Purdue-AM/CPT_printer/Plasma Printer Photos/20190710_125836.jpg

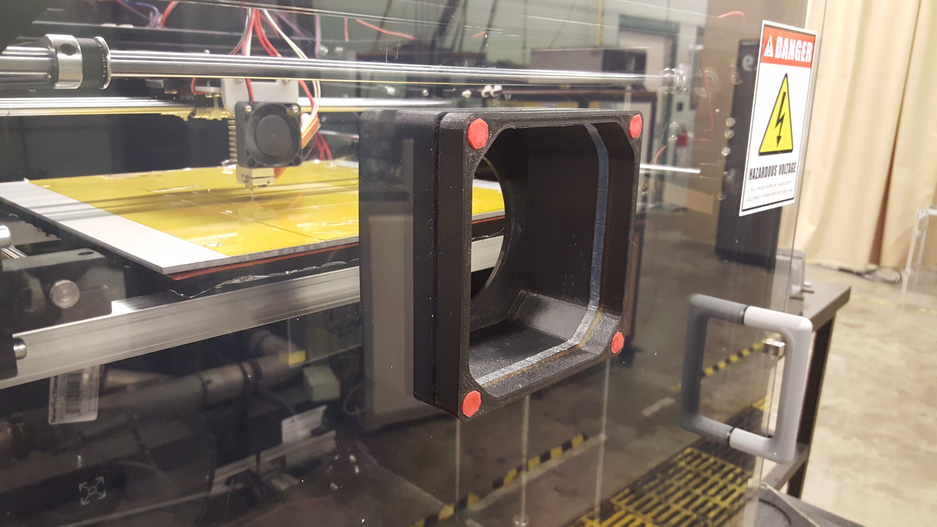
Plasma Printer Photos/20190710_125836.jpg
