Purdue-AM/CPT_printer/Plasma Printer Photos/20190710_130702.jpg

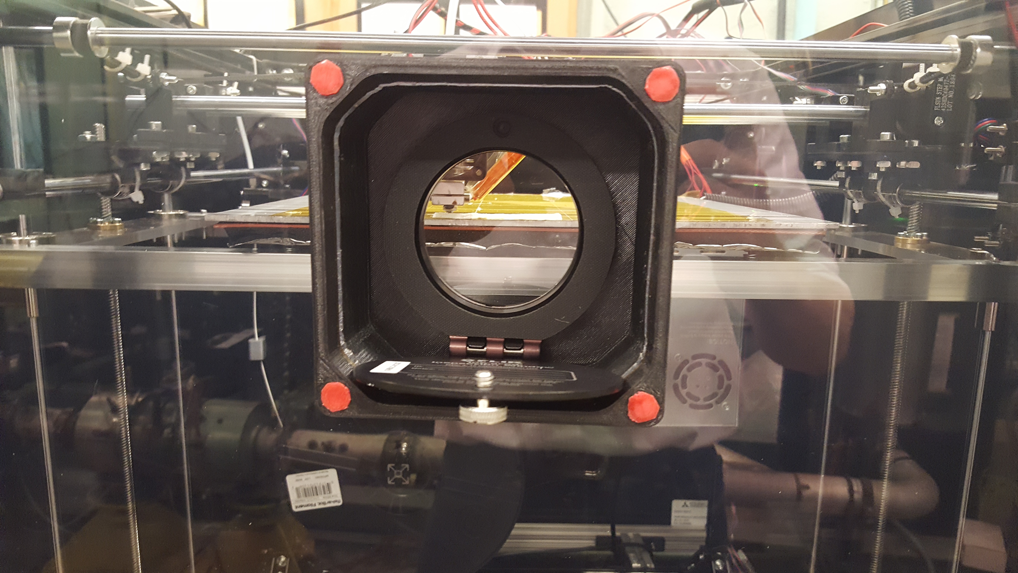
Plasma Printer Photos/20190710_130702.jpg
