Purdue-AM/CPT_printer/README.md

# CPT_printer
Mechanical, electrical, and code files for the Corona/Cold Plasma Treatment Printer in the Rhoads Research Group at Purdue University.
