Purdue-AM/CPT_printer/Plasma Printer Hardware/Ozone Sensor Mount/ozone_mount.SLDASM

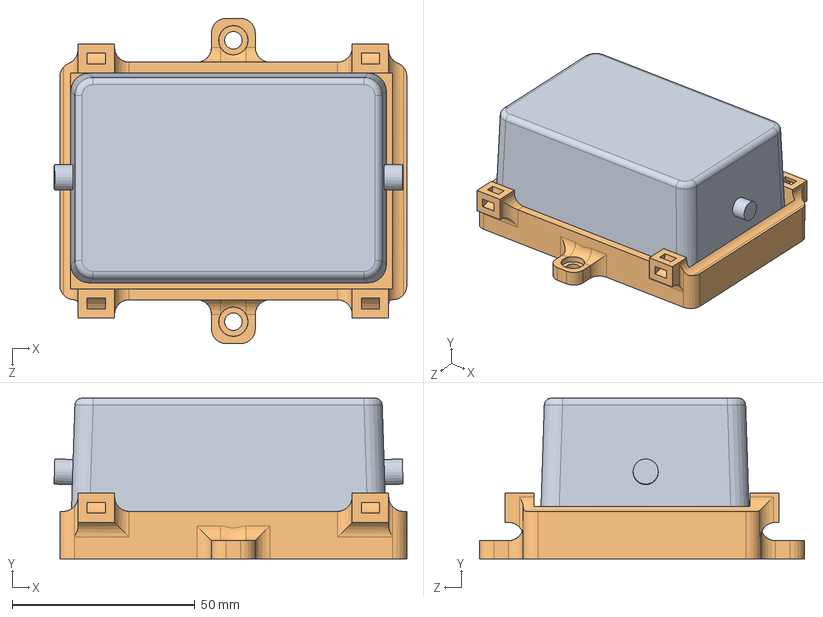
[picture p3: CAD file, 2019-09-11]
Plasma Printer Hardware/Ozone Sensor Mount/ozone_mount.SLDASM
96.6 x 44.0 x 89.0 mm
ozone sensor
mount_bottom
