Purdue-AM/CPT_printer/Plasma Printer Hardware/Print Head Assembly/STLs/plasma_frame_test.STL

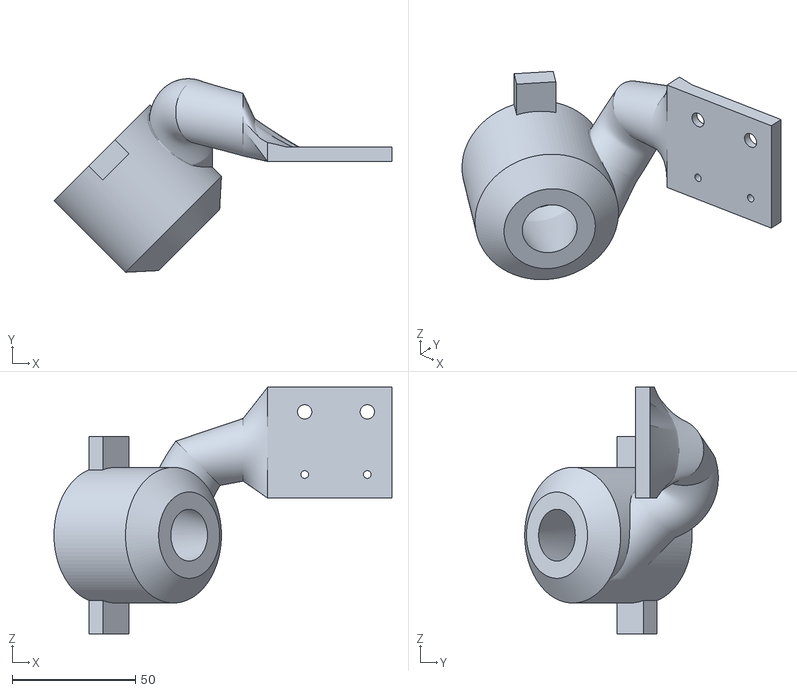
[picture p4: CAD file, 2019-09-11]
Plasma Printer Hardware/Print Head Assembly/STLs/plasma_frame_test.STL
137.0 x 78.5 x 100.0
