Purdue-AM/CPT_printer/Plasma Printer Hardware/Print Head Assembly/plasma_front_cone.SLDPRT

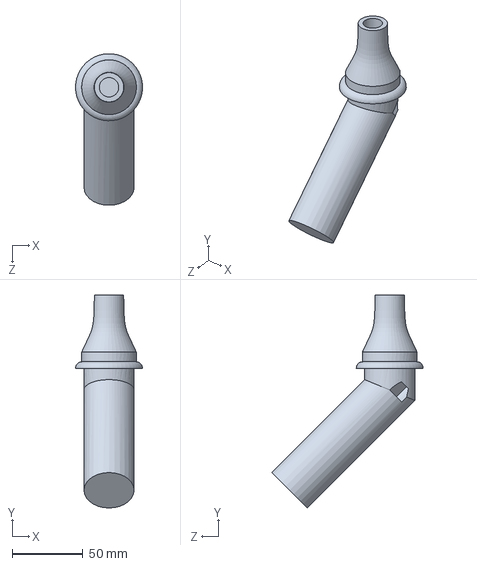
[picture p5: CAD file, 2019-09-11]
Plasma Printer Hardware/Print Head Assembly/plasma_front_cone.SLDPRT
47.3 x 150.2 x 106.8 mm
