Purdue-AM/CPT_printer/Plasma Printer Hardware/IR Window Sub-Assembly/Window Assembly.SLDASM

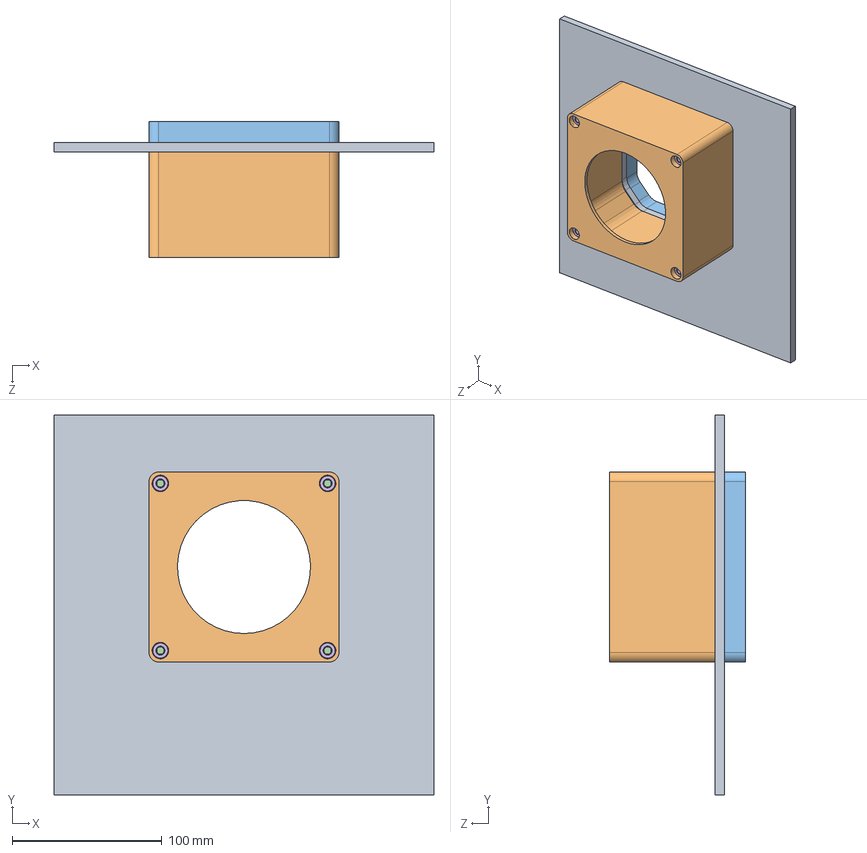
[picture p6: CAD file, 2019-09-11]
Plasma Printer Hardware/IR Window Sub-Assembly/Window Assembly.SLDASM
254.0 x 254.0 x 91.1 mm
Door
conductive bushing
conductive bushing outside
socket head cap screw_am x 4
bolt cover x 4
hex nut style 1_am x 4
