Purdue-AM/CPT_printer/Plasma Printer Hardware/Print Head Assembly/print head assembly.SLDASM

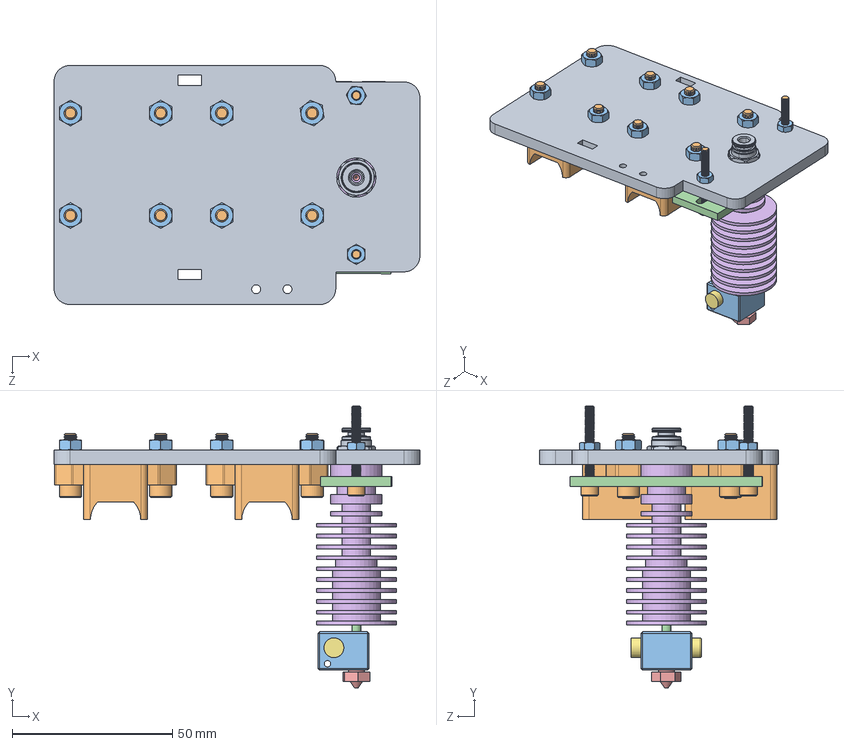
[picture p7: CAD file, 2019-09-11]
Plasma Printer Hardware/Print Head Assembly/print head assembly.SLDASM
114.4 x 88.0 x 74.7 mm
mounting plate
bearing housing x 4
E3D Heat Block
E3D Heatbreak
E3D Nozzle
E3D Heatsink
cartridge heater
thermistor
PB156_1_8
socket head cap screw_am x 10
hex nut style 1_am x 10
hotend bracket
