Purdue-AM/CPT_printer/Plasma Printer Hardware/Enclosure Parts/back_door_hinge.SLDASM

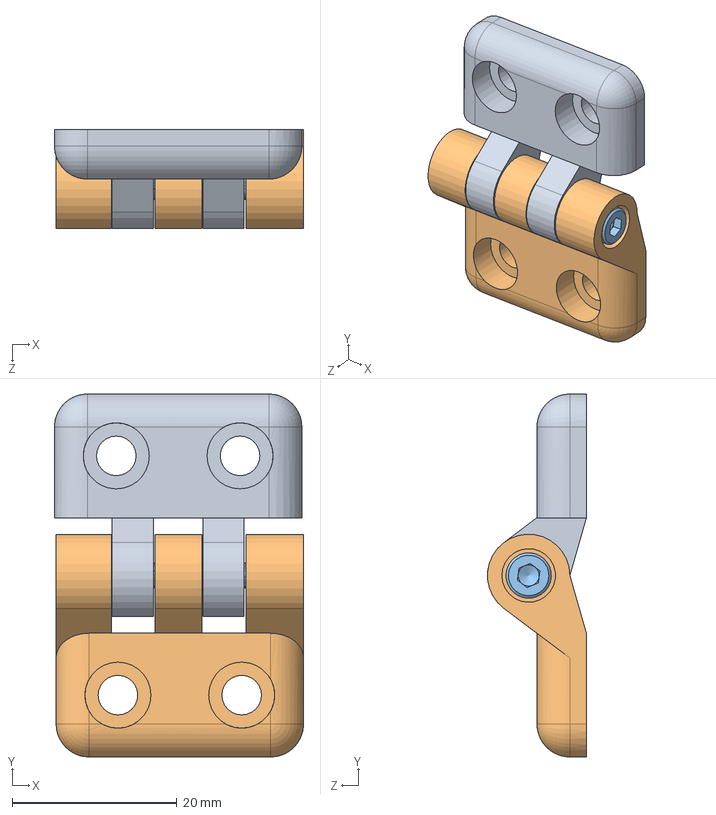
[picture p8: CAD file, 2019-09-11]
Plasma Printer Hardware/Enclosure Parts/back_door_hinge.SLDASM
30.2 x 44.0 x 12.0 mm
hinge_arm
hinge_backdoor_base
socket head cap screw_am
