Purdue-AM/CPT_printer/Plasma Printer Hardware/Print Head Assembly/Hot End Assembly/E3D.SLDASM

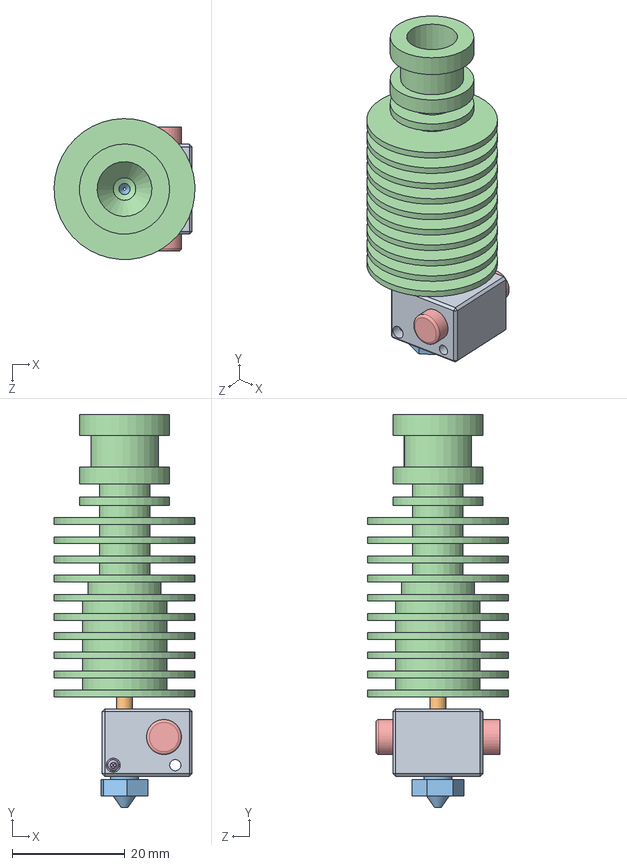
[picture p9: CAD file, 2019-09-11]
Plasma Printer Hardware/Print Head Assembly/Hot End Assembly/E3D.SLDASM
25.0 x 69.7 x 25.0 mm
E3D Heat Block
E3D Heatbreak
E3D Nozzle
E3D Heatsink
cartridge heater
thermistor
