Purdue-AM/CPT_printer/Plasma Printer Hardware/Print Head Assembly/plasma_frame.SLDPRT

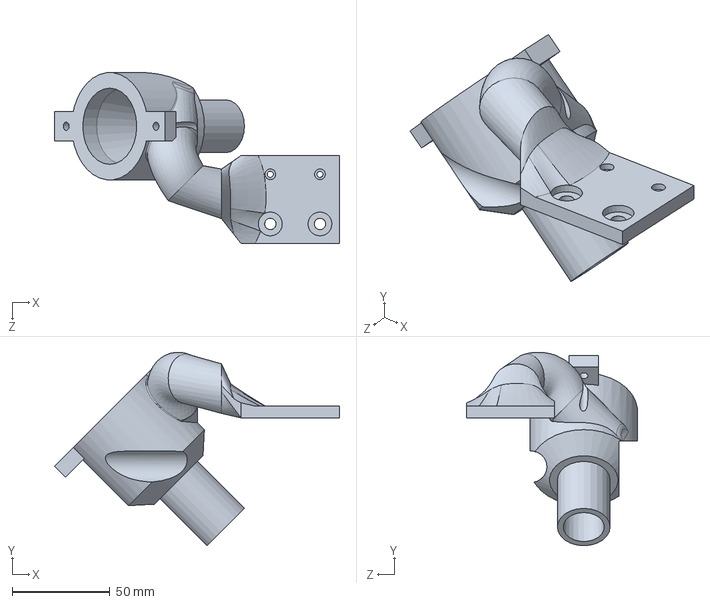
[picture p10: CAD file, 2019-09-11]
Plasma Printer Hardware/Print Head Assembly/plasma_frame.SLDPRT
145.9 x 99.0 x 87.5 mm
