Purdue-AM/CPT_printer/Plasma Printer Hardware/Print Head Assembly/plasma_frame_top.SLDPRT

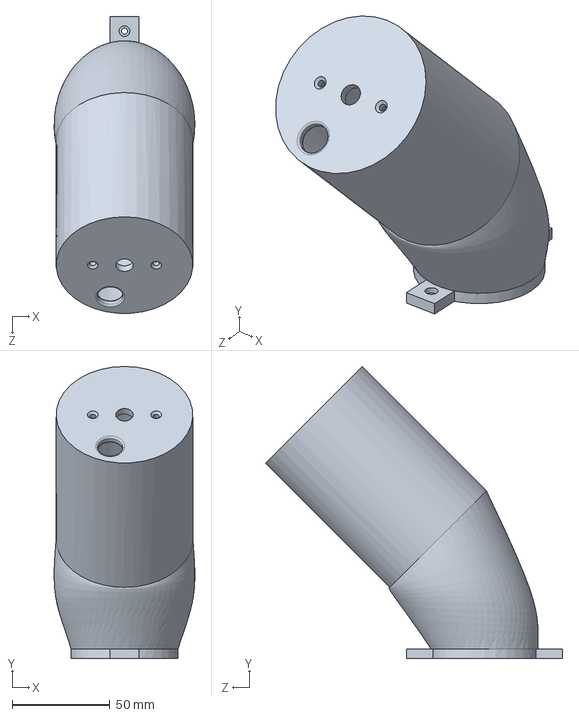
[picture p11: CAD file, 2019-09-11]
Plasma Printer Hardware/Print Head Assembly/plasma_frame_top.SLDPRT
72.0 x 149.6 x 152.1 mm
