Purdue-AM/CPT_printer/Plasma Printer Hardware/Print Head Assembly/new frame assembly.SLDASM

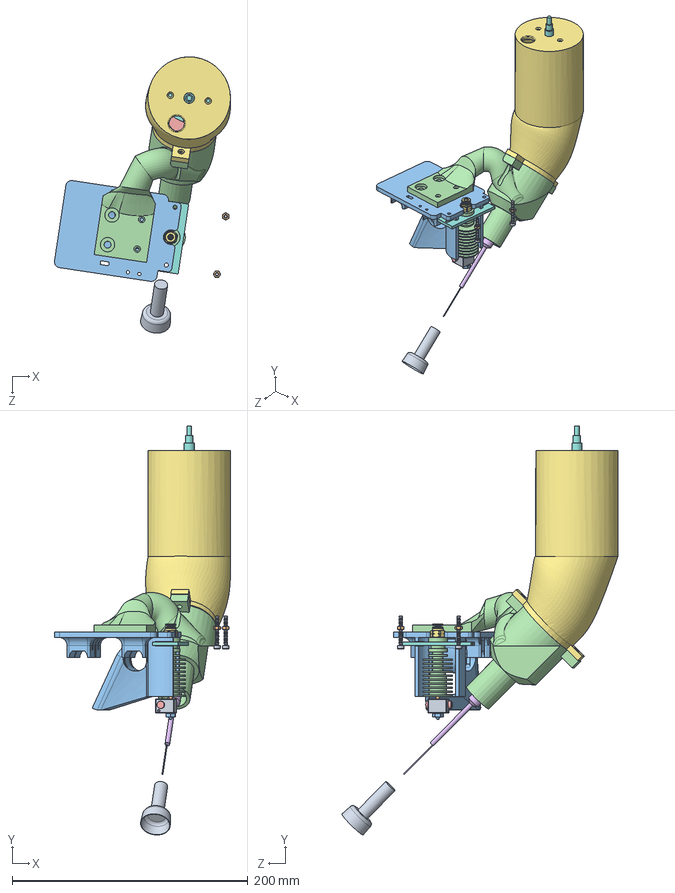
[picture p12: CAD file, 2019-09-11]
Plasma Printer Hardware/Print Head Assembly/new frame assembly.SLDASM
149.5 x 347.2 x 234.5 mm
E3D Heat Block
E3D Heatbreak
E3D Nozzle
E3D Heatsink
cartridge heater
thermistor
PB156_1_8
hotend bracket
socket head cap screw_am x 2
hex nut style 1_am x 2
combined_frame
plasma_frame
plasma_front_cone
needle_tip
plasma_frame_top
spark_gap
cup_tip
