Purdue-AM/CPT_printer/Plasma Printer Hardware/Enclosure Parts/hinge_backdoor_base.SLDPRT

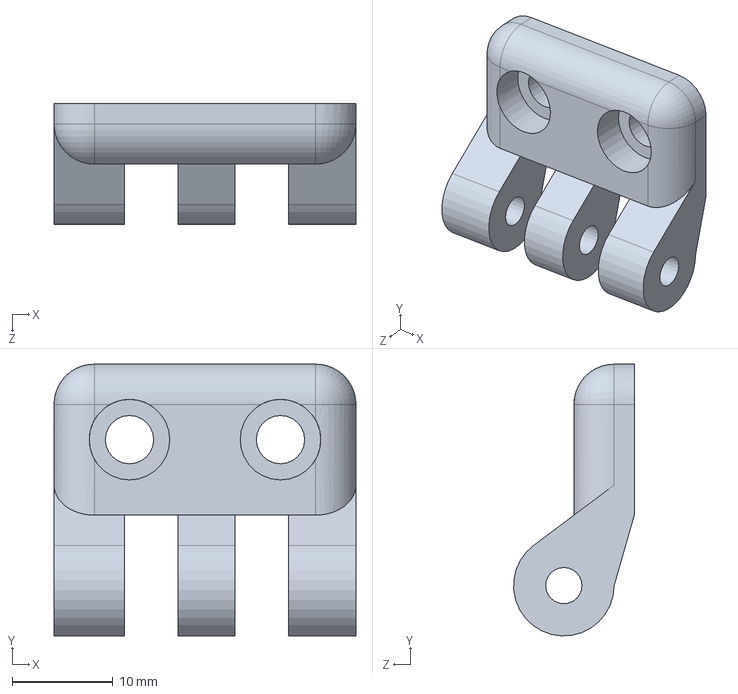
[picture p13: CAD file, 2019-09-11]
Plasma Printer Hardware/Enclosure Parts/hinge_backdoor_base.SLDPRT
30.0 x 27.0 x 12.0 mm
