Purdue-AM/CPT_printer/Plasma Printer Hardware/IR Window Sub-Assembly/conductive bushing outside.SLDPRT

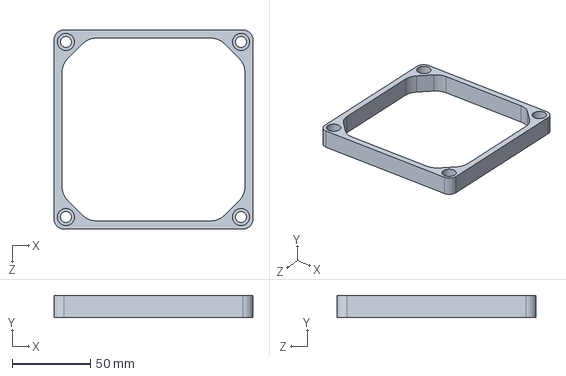
[picture p14: CAD file, 2019-09-11]
Plasma Printer Hardware/IR Window Sub-Assembly/conductive bushing outside.SLDPRT
127.0 x 14.3 x 127.0 mm
