Purdue-AM/CPT_printer/Plasma Printer Hardware/Plasma Generator Parts/cup_tip.SLDPRT

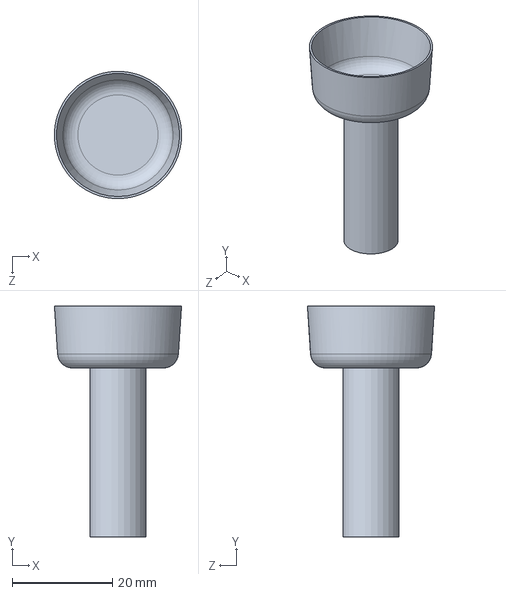
[picture p15: CAD file, 2019-09-11]
Plasma Printer Hardware/Plasma Generator Parts/cup_tip.SLDPRT
25.3 x 46.0 x 25.3 mm
