Purdue-AM/CPT_printer/Plasma Printer Hardware/Print Head Assembly/new_frame.SLDPRT

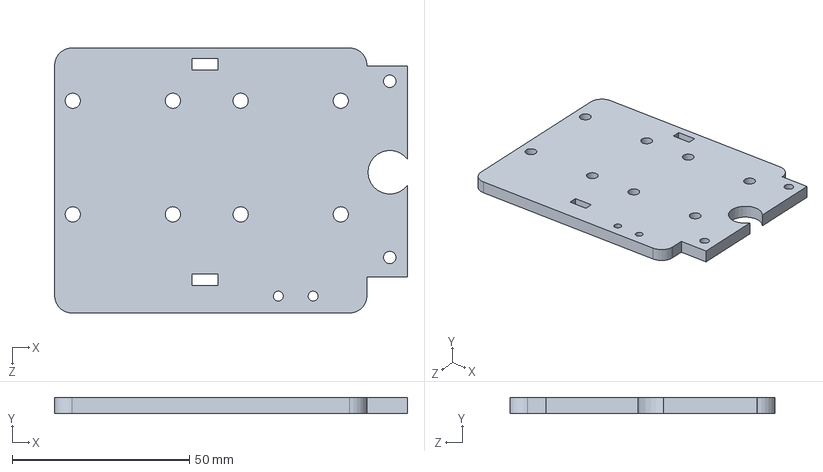
[picture p16: CAD file, 2019-09-11]
Plasma Printer Hardware/Print Head Assembly/new_frame.SLDPRT
99.4 x 4.55 x 74.7 mm
