Purdue-AM/CPT_printer/Plasma Printer Hardware/Enclosure Parts/2020_conn.SLDPRT

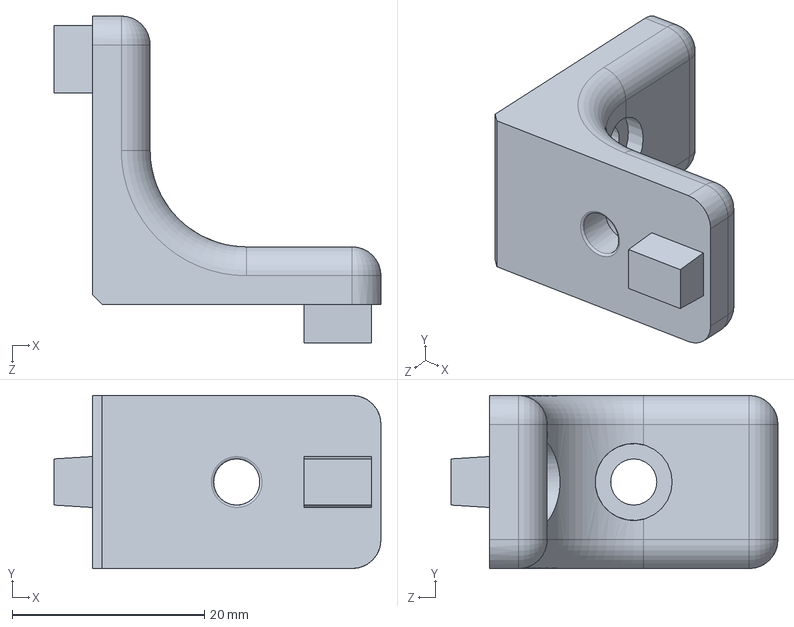
[picture p17: CAD file, 2019-09-11]
Plasma Printer Hardware/Enclosure Parts/2020_conn.SLDPRT
34.0 x 18.0 x 34.0 mm
