Purdue-AM/CPT_printer/Plasma Printer Hardware/IR Window Sub-Assembly/conductive bushing.SLDPRT

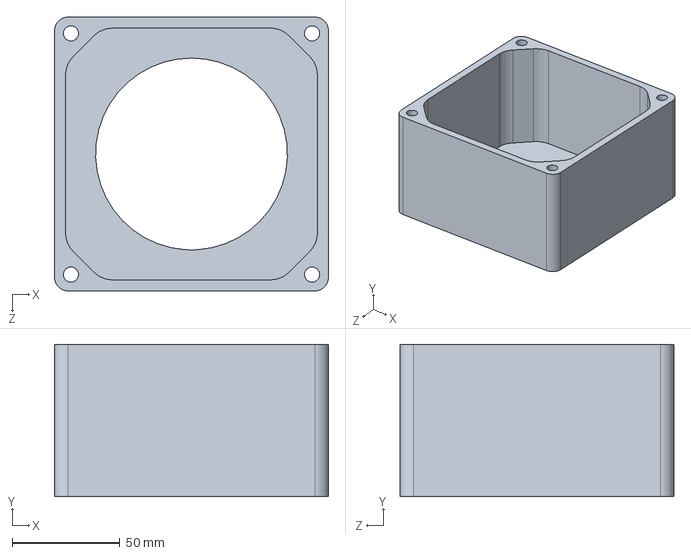
[picture p18: CAD file, 2019-09-11]
Plasma Printer Hardware/IR Window Sub-Assembly/conductive bushing.SLDPRT
127.0 x 70.5 x 127.0 mm
