Purdue-AM/CPT_printer/Plasma Printer Hardware/Ozone Sensor Mount/ozone sensor.SLDPRT

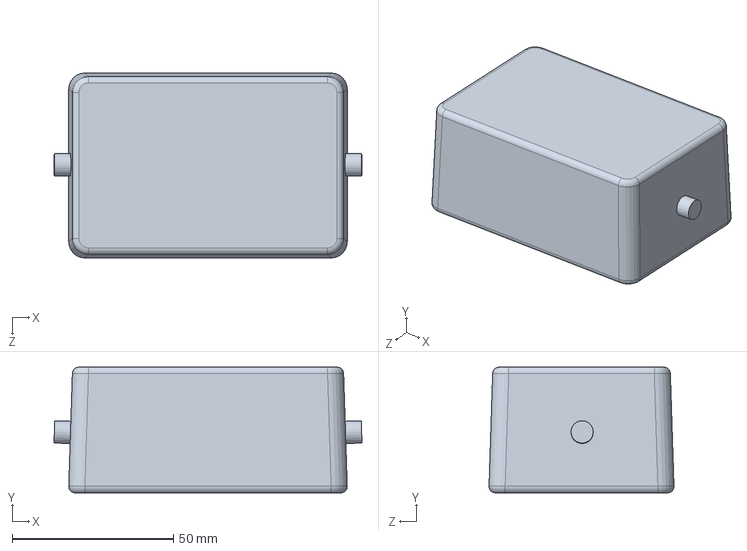
[picture p19: CAD file, 2019-09-11]
Plasma Printer Hardware/Ozone Sensor Mount/ozone sensor.SLDPRT
95.5 x 39.0 x 57.4 mm
