Purdue-AM/CPT_printer/Plasma Printer Hardware/Plasma Generator Parts/needle_tip.SLDPRT

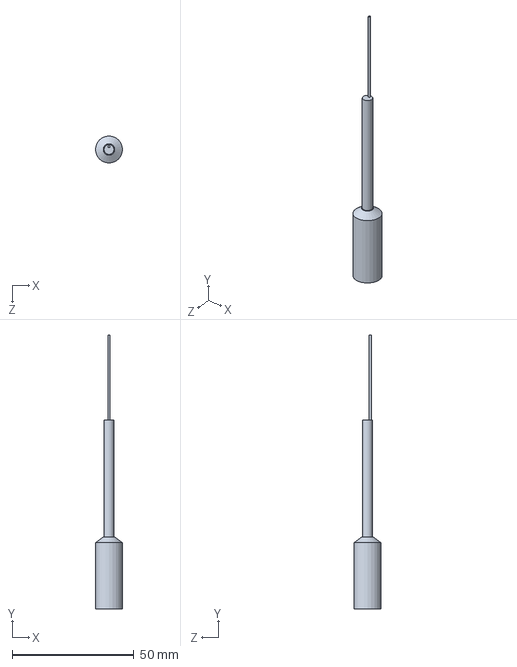
[picture p20: CAD file, 2019-09-11]
Plasma Printer Hardware/Plasma Generator Parts/needle_tip.SLDPRT
11.1 x 112.6 x 11.1 mm
