Purdue-AM/CPT_printer/Plasma Printer Hardware/Enclosure Parts/hinge_base.SLDPRT

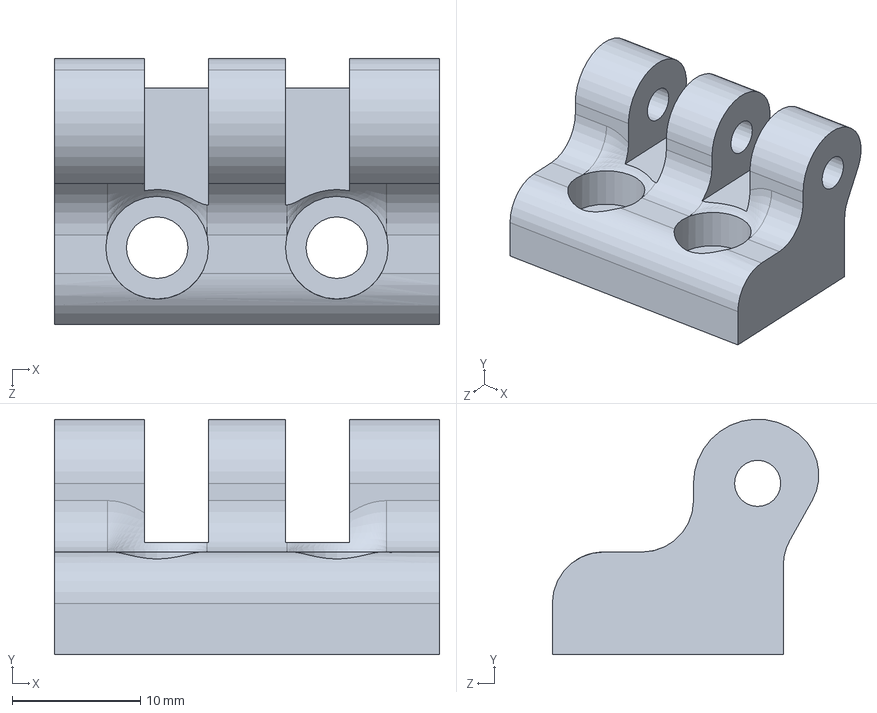
[picture p21: CAD file, 2019-09-11]
Plasma Printer Hardware/Enclosure Parts/hinge_base.SLDPRT
30.0 x 18.3 x 20.8 mm
