Purdue-AM/CPT_printer/Plasma Printer Hardware/IR Window Sub-Assembly/Door.SLDPRT

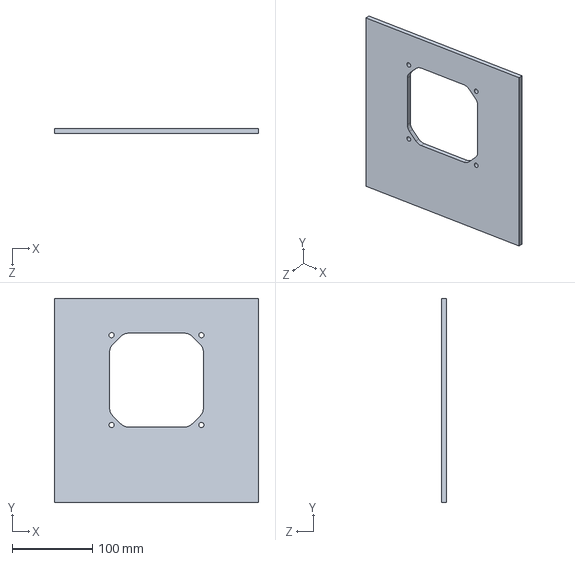
[picture p22: CAD file, 2019-09-11]
Plasma Printer Hardware/IR Window Sub-Assembly/Door.SLDPRT
254.0 x 254.0 x 6.35 mm
