Purdue-AM/CPT_printer/Plasma Printer Hardware/Ozone Sensor Mount/mount_bottom.SLDPRT

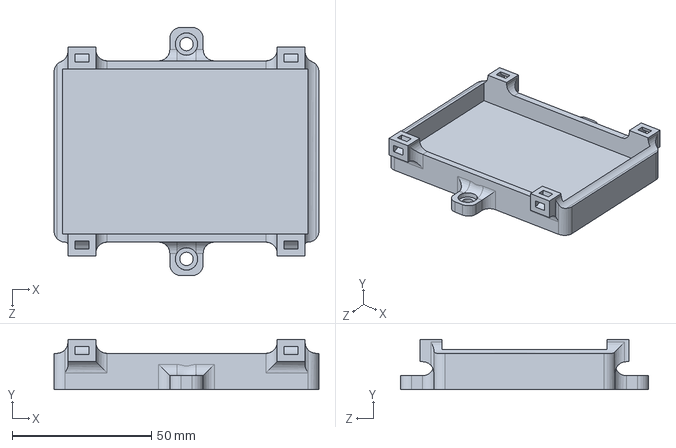
[picture p23: CAD file, 2019-09-11]
Plasma Printer Hardware/Ozone Sensor Mount/mount_bottom.SLDPRT
95.0 x 18.0 x 89.0 mm
