Purdue-AM/CPT_printer/Plasma Printer Hardware/Plasma Generator Parts/spark_gap.SLDPRT

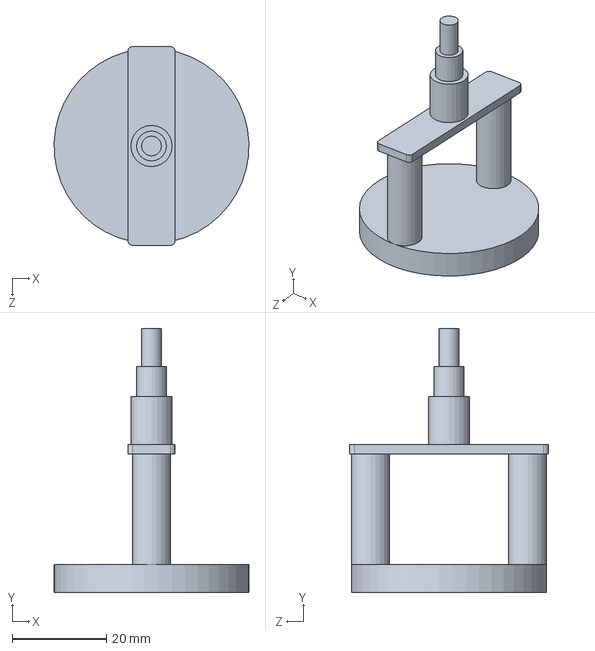
[picture p24: CAD file, 2019-09-11]
Plasma Printer Hardware/Plasma Generator Parts/spark_gap.SLDPRT
41.3 x 55.9 x 42.1 mm
