Purdue-AM/CPT_printer/Plasma Printer Hardware/Print Head Assembly/hotend bracket.SLDPRT

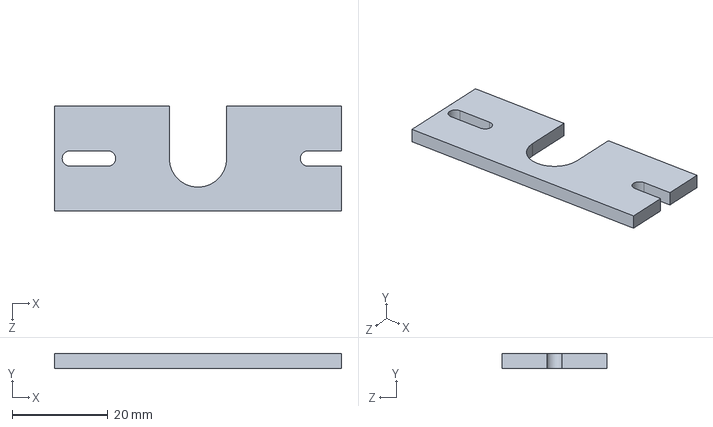
[picture p25: CAD file, 2019-09-11]
Plasma Printer Hardware/Print Head Assembly/hotend bracket.SLDPRT
60.0 x 3.04 x 22.0 mm
