Purdue-AM/CPT_printer/Plasma Printer Hardware/IR Window Sub-Assembly/conductive bushing inside.SLDPRT

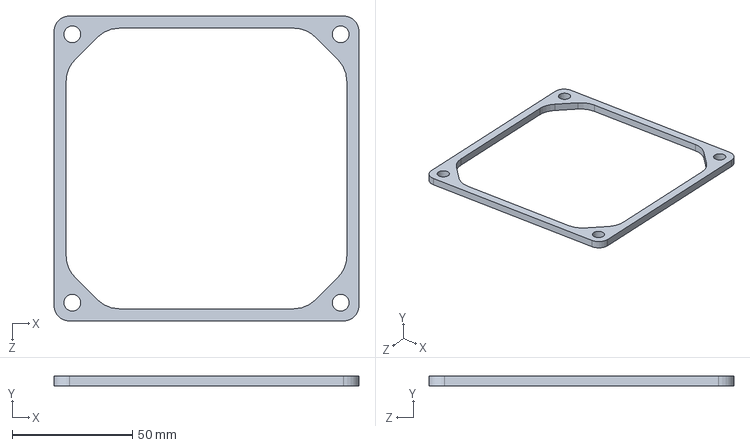
[picture p27: CAD file, 2019-09-11]
Plasma Printer Hardware/IR Window Sub-Assembly/conductive bushing inside.SLDPRT
127.0 x 4.13 x 127.0 mm
