Purdue-AM/CPT_printer/Plasma Printer Hardware/Print Head Assembly/Hot End Assembly/thermistor.SLDPRT

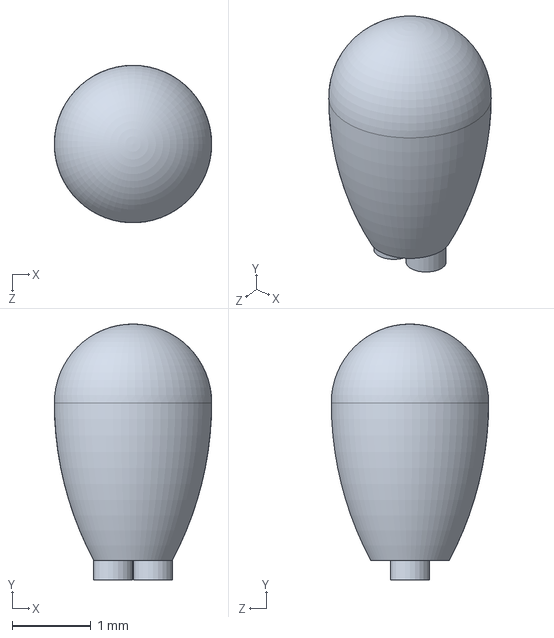
[picture p28: CAD file, 2019-09-11]
Plasma Printer Hardware/Print Head Assembly/Hot End Assembly/thermistor.SLDPRT
2.00 x 3.25 x 2.00 mm
