Purdue-AM/CPT_printer/Plasma Printer Hardware/Enclosure Parts/fan_mount.SLDPRT

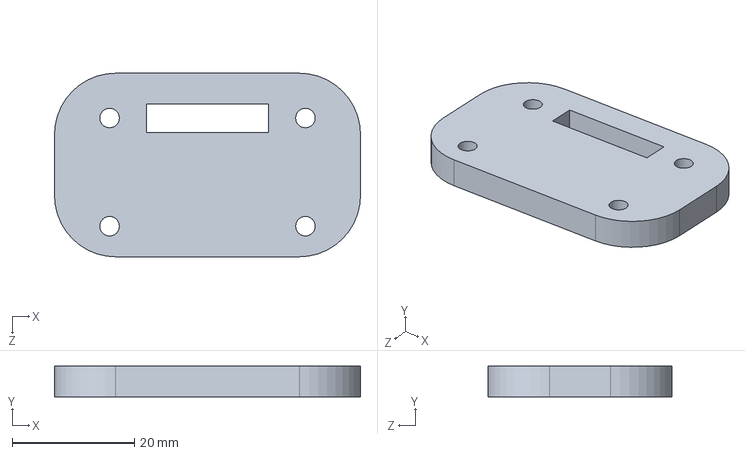
[picture p29: CAD file, 2019-09-11]
Plasma Printer Hardware/Enclosure Parts/fan_mount.SLDPRT
50.0 x 5.00 x 30.0 mm
