Purdue-AM/CPT_printer/Plasma Printer Hardware/Print Head Assembly/Hot End Assembly/E3D Heat Block.SLDPRT

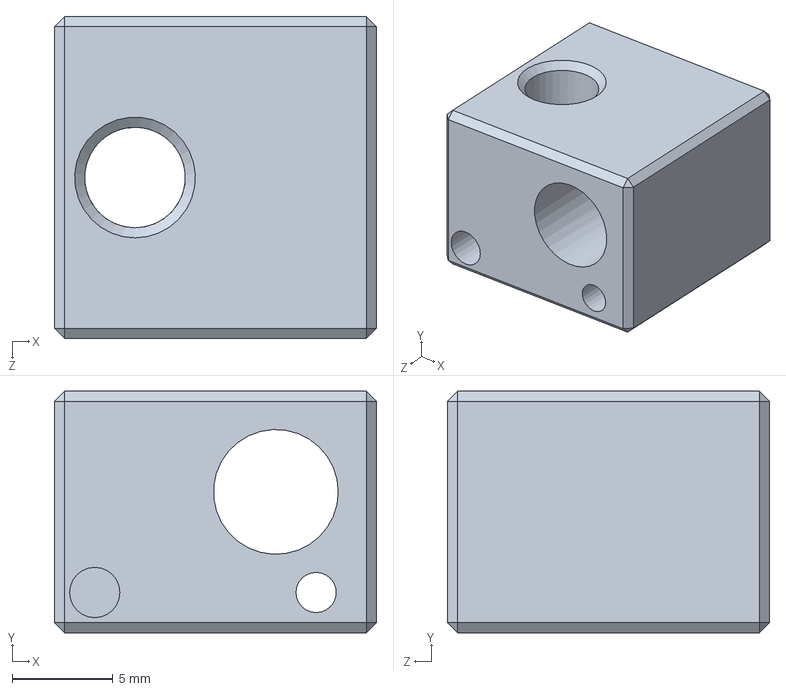
[picture p30: CAD file, 2019-09-11]
Plasma Printer Hardware/Print Head Assembly/Hot End Assembly/E3D Heat Block.SLDPRT
16.0 x 12.0 x 16.0 mm
