Purdue-AM/CPT_printer/Plasma Printer Hardware/Print Head Assembly/spark_protector.STL

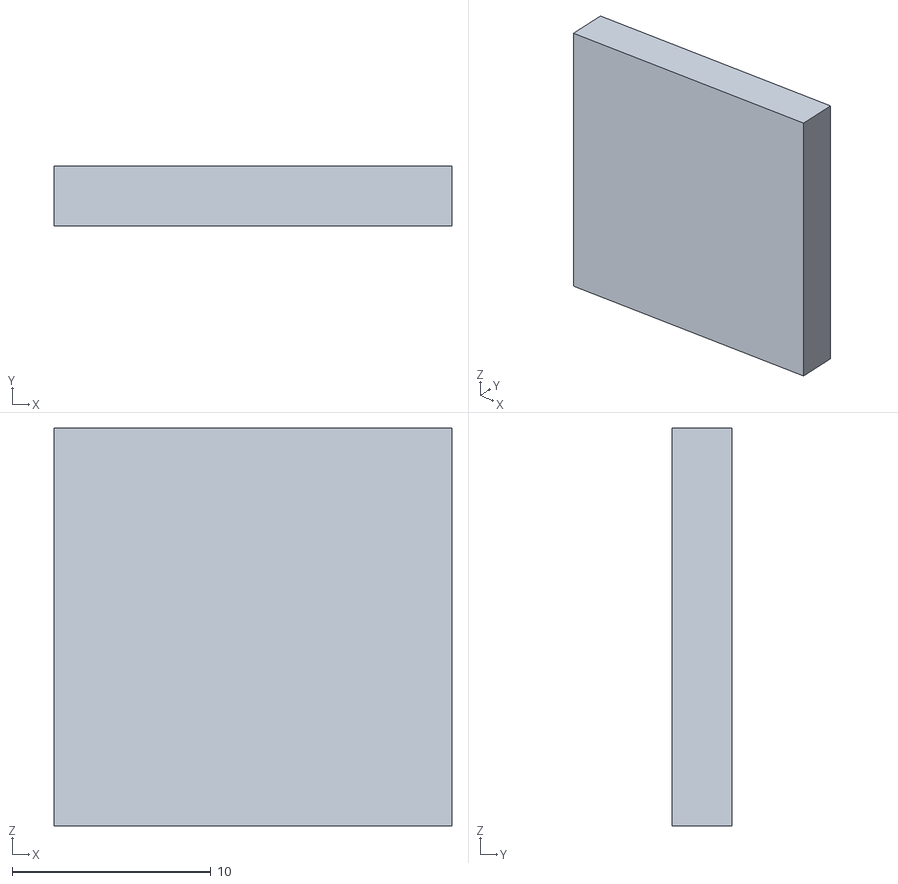
[picture p31: CAD file, 2019-09-11]
Plasma Printer Hardware/Print Head Assembly/spark_protector.STL
20.0 x 3.00 x 20.0
