Purdue-AM/CPT_printer/Plasma Printer Hardware/Print Head Assembly/combined_frame.SLDPRT

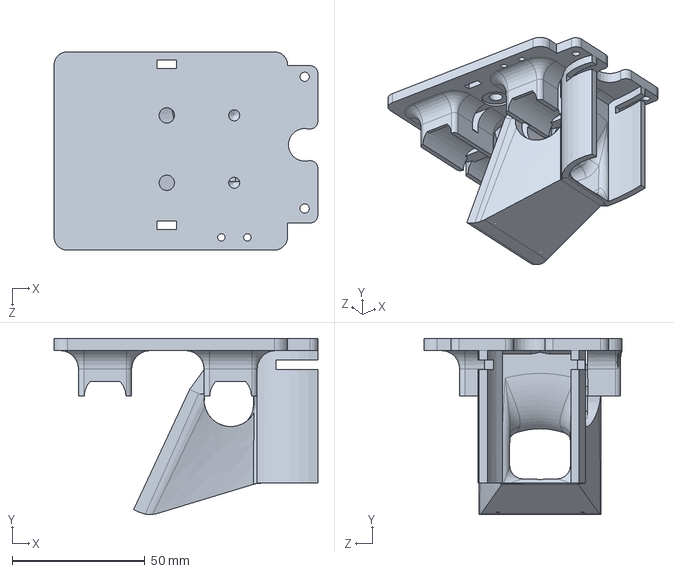
[picture p32: CAD file, 2019-09-11]
Plasma Printer Hardware/Print Head Assembly/combined_frame.SLDPRT
99.5 x 66.3 x 74.7 mm
