Purdue-AM/CPT_printer/Plasma Printer Hardware/Print Head Assembly/Hot End Assembly/E3D Heatbreak.SLDPRT

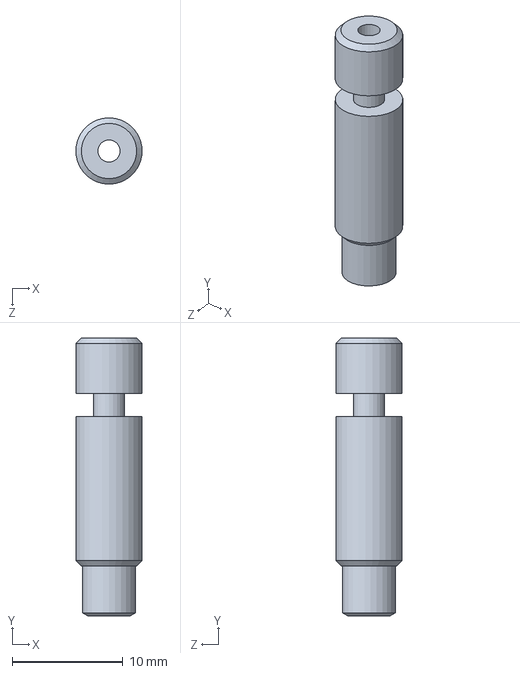
[picture p33: CAD file, 2019-09-11]
Plasma Printer Hardware/Print Head Assembly/Hot End Assembly/E3D Heatbreak.SLDPRT
5.97 x 25.1 x 6.00 mm
