Purdue-AM/CPT_printer/Plasma Printer Hardware/Print Head Assembly/mounting plate.SLDPRT

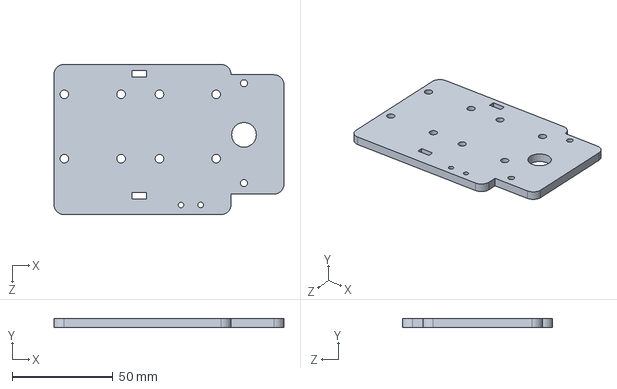
[picture p34: CAD file, 2019-09-11]
Plasma Printer Hardware/Print Head Assembly/mounting plate.SLDPRT
114.4 x 4.55 x 74.7 mm
