Purdue-AM/CPT_printer/Plasma Printer Hardware/Print Head Assembly/bearing housing.SLDPRT

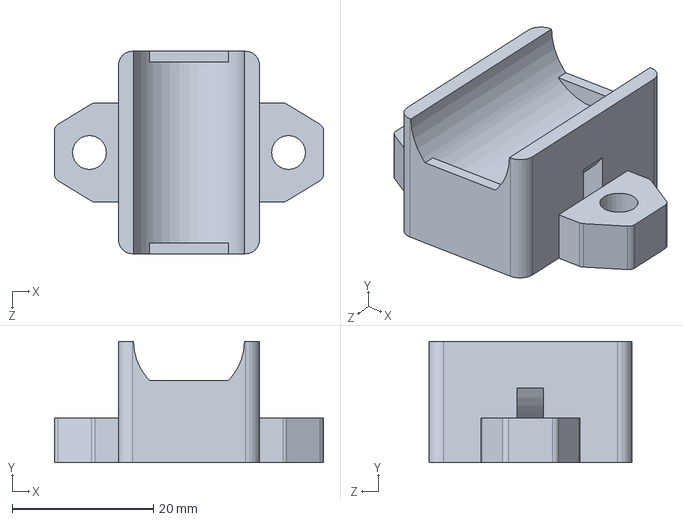
[picture p35: CAD file, 2019-09-11]
Plasma Printer Hardware/Print Head Assembly/bearing housing.SLDPRT
38.1 x 17.1 x 28.7 mm
