Purdue-AM/CPT_printer/Plasma Printer Hardware/Print Head Assembly/Hot End Assembly/E3D Nozzle.SLDPRT

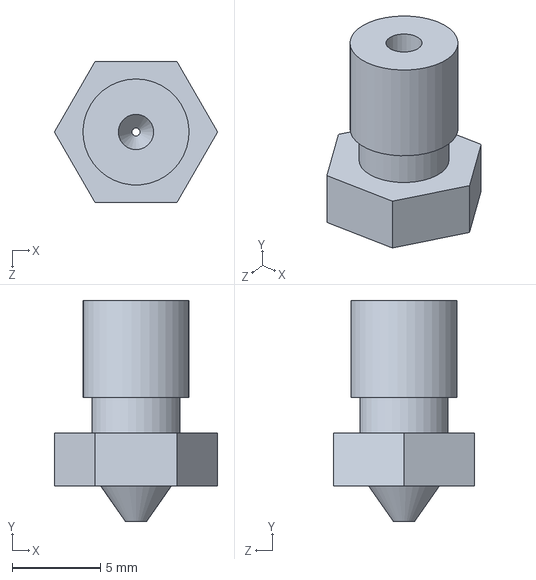
[picture p36: CAD file, 2019-09-11]
Plasma Printer Hardware/Print Head Assembly/Hot End Assembly/E3D Nozzle.SLDPRT
9.24 x 12.5 x 8.00 mm
