Purdue-AM/CPT_printer/Plasma Printer Hardware/Print Head Assembly/Hot End Assembly/E3D Heatsink.SLDPRT

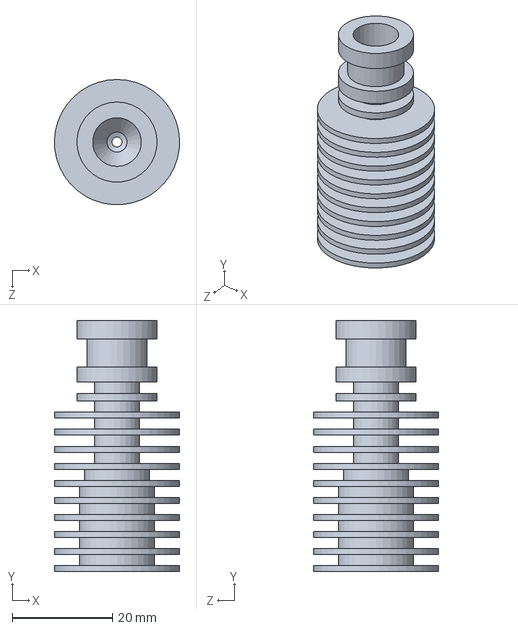
[picture p37: CAD file, 2019-09-11]
Plasma Printer Hardware/Print Head Assembly/Hot End Assembly/E3D Heatsink.SLDPRT
25.0 x 50.1 x 25.0 mm
