Purdue-AM/CPT_printer/Plasma Printer Hardware/Print Head Assembly/Hot End Assembly/cartridge heater.SLDPRT

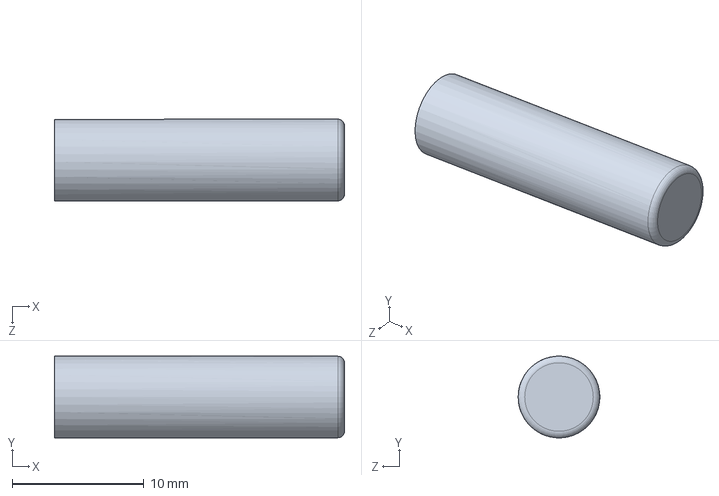
[picture p38: CAD file, 2019-09-11]
Plasma Printer Hardware/Print Head Assembly/Hot End Assembly/cartridge heater.SLDPRT
22.0 x 6.19 x 6.20 mm
