Purdue-AM/CPT_printer/(list of files, cad)

Other CAD files:
Plasma Printer Hardware/Print Head Assembly/Hot End Assembly/E3D_1.sldasm
Plasma Printer Hardware/Print Head Assembly/Hot End Assembly/cartridge heater_1.sldprt
Plasma Printer Hardware/Print Head Assembly/Hot End Assembly/E3D Heatbreak_1.sldprt
Plasma Printer Hardware/Print Head Assembly/PB156_1_8.sldprt
Plasma Printer Hardware/Print Head Assembly/Hot End Assembly/E3D Heatsink_1.75 Bowden.sldprt
Plasma Printer Hardware/Print Head Assembly/Hot End Assembly/E3D Heat Block_1.sldprt
Plasma Printer Hardware/Print Head Assembly/Hot End Assembly/E3D Nozzle_1.sldprt
Plasma Printer Hardware/Enclosure Parts/2020_conn.STL
Plasma Printer Hardware/Enclosure Parts/hinge_arm.STL
Plasma Printer Hardware/Enclosure Parts/hinge_backdoor_base.STL
Plasma Printer Hardware/IR Window Sub-Assembly/Door.DXF
Plasma Printer Hardware/IR Window Sub-Assembly/bolt cover.SLDPRT
Plasma Printer Hardware/IR Window Sub-Assembly/bolt cover.STL
Plasma Printer Hardware/IR Window Sub-Assembly/conductive bushing inside.STL
Plasma Printer Hardware/IR Window Sub-Assembly/conductive bushing outside.STL
Plasma Printer Hardware/IR Window Sub-Assembly/conductive bushing.STL
Plasma Printer Hardware/Ozone Sensor Mount/mount_bottom.STL
Plasma Printer Hardware/Print Head Assembly/STLs/combined_frame.STL
Plasma Printer Hardware/Print Head Assembly/STLs/plasma_frame.STL
