Purdue-AM/CPT_printer/(threads)

Thread 1 (2019-09-12):

New Plasma wand

jcsmccaw, 2019-09-12:
Current plasma wand can't produce enough power without arcing to the printer. New plasma wand needs to be ID'd, sourced, and new mounting fixtures need to be added to it.
