Purdue-AM/CPT_printer/Plasma Printer Hardware/IR Window Sub-Assembly/Window Assembly.PDF

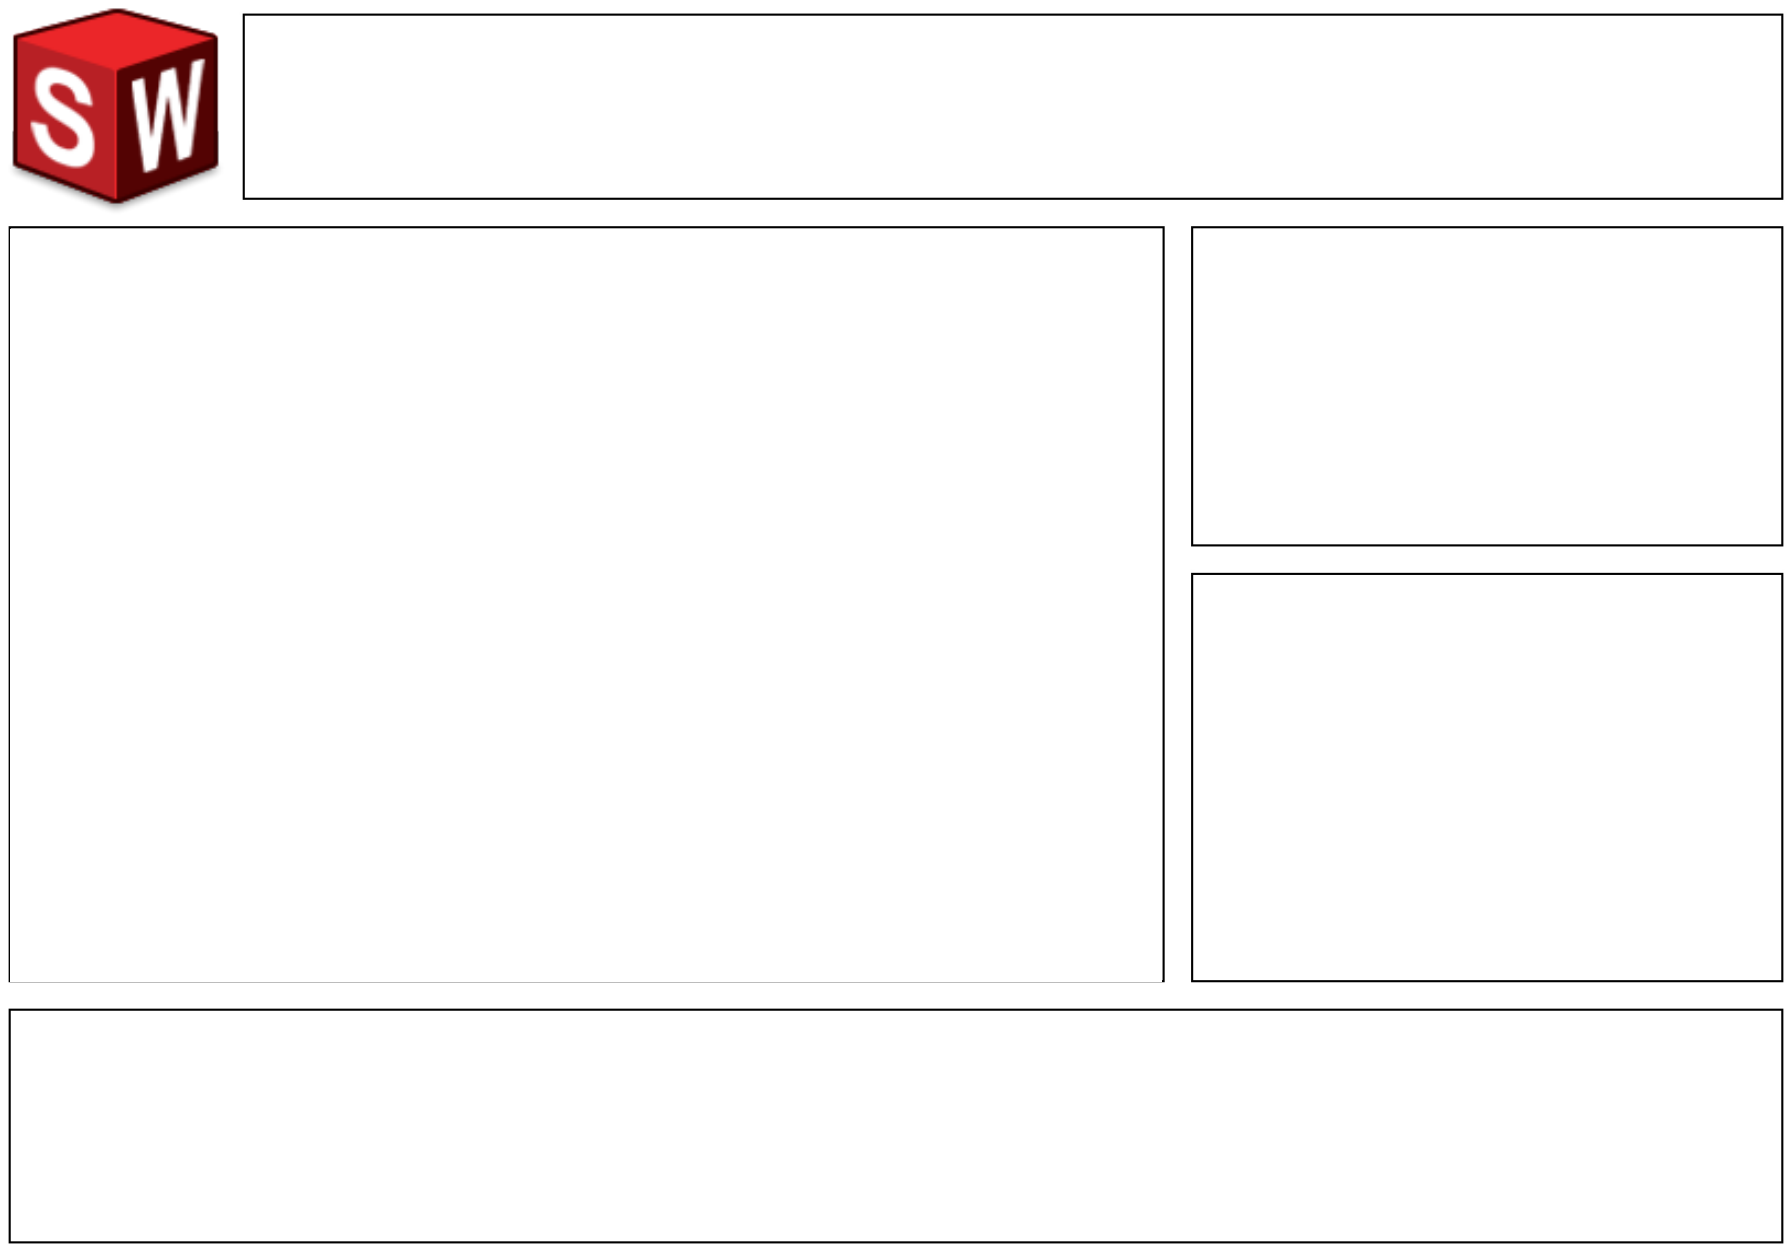
[picture p43: page 1]

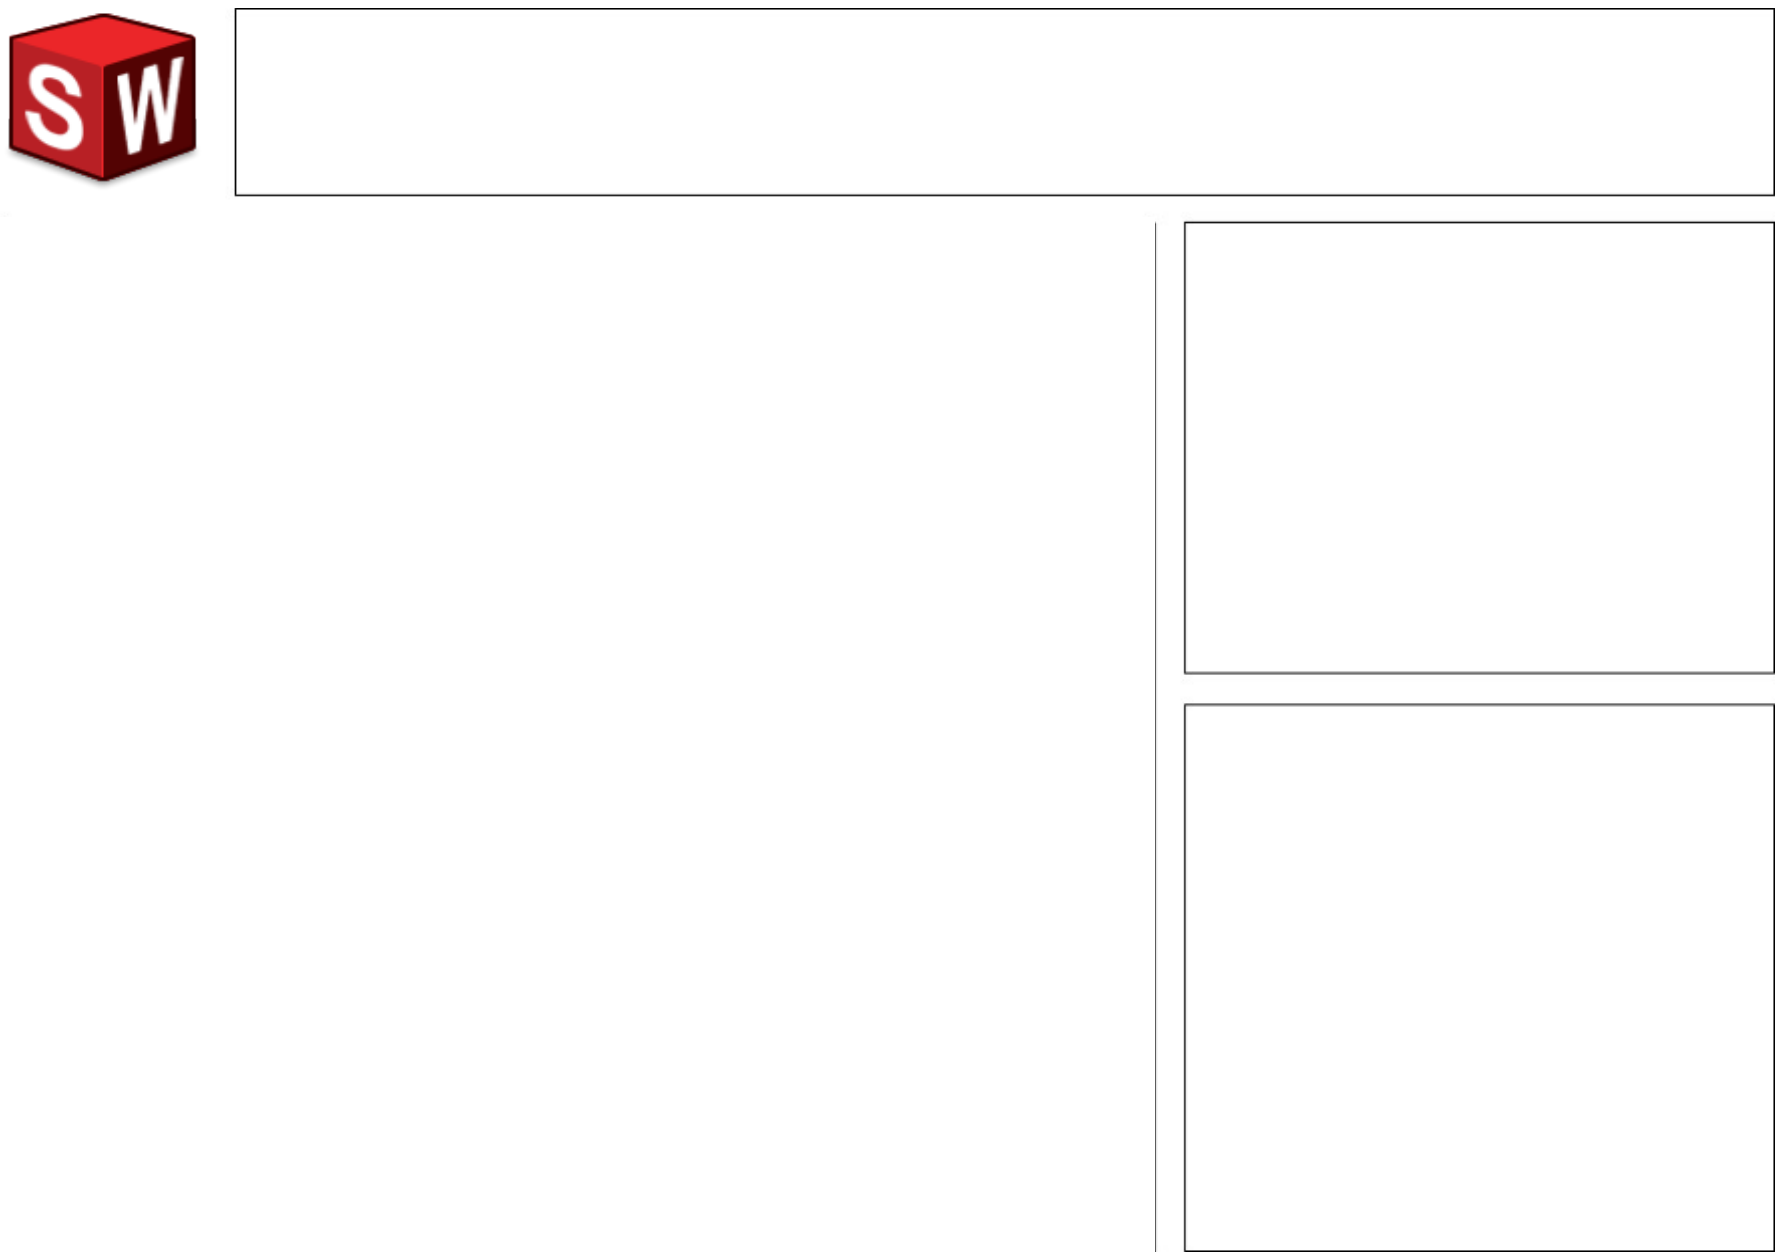
[picture p44: page 2]
