Purdue-AM/CPT_printer/(commit log)

2019-09-11 Add files via upload
    Hardware, SoP, and Lit. Review papers for plasma printer.
    [2020_conn.SLDPRT, 2020_conn.STL, Door.DXF, Door.SLDPRT, E3D Heat Block.SLDPRT, E3D Heat Block_1.sldprt, E3D Heatbreak.SLDPRT, E3D Heatbreak_1.sldprt]
2019-09-11 Firmware added
    The latest version of Marlin was edited for the printer, firmware edits are useful in custom operation.
    [Configuration.h, Configuration_adv.h]
