Purdue-AM/CPT_printer/Plasma Printer Photos/20190710_130122.jpg

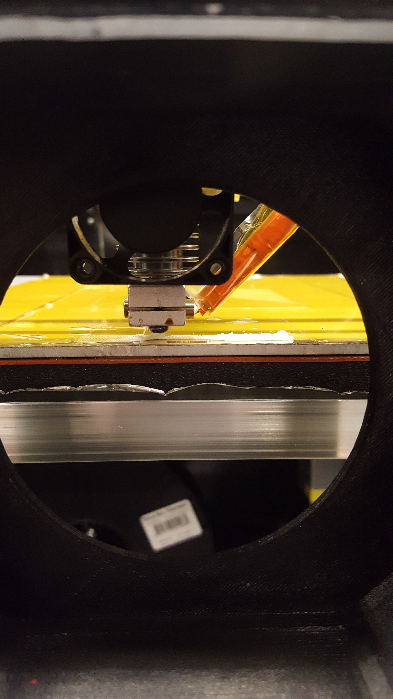
Plasma Printer Photos/20190710_130122.jpg
